AriM224/Beyblade-Melty-Brain-Kit/README.md

# Beyblade-Melty-Brain-Kit
First 1lb plastic melty brain combat robot kit! This repository will be mostly for the code.

*Please note that I'm a mechanical engineer, so the code may not meet CS standards*
