AriM224/Beyblade-Melty-Brain-Kit/Electronics/Brain Rot Parts List.xlsx

Item | Notes | Link | Quantity/bot | Price | Total Cost
Palm Beach 1100kv 2822 Weapon Motor | glue stator because bad pressfit | https://palmbeachbots.com/products/d2822-brushless-outrunner-1100kv-4mm-shaft-viper-compatible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 | 2 | $16.00 | $178.40
Repeat 35A AM32 ESC | Needs to be programmed | https://repeat-robotics.com/buy/am32/ | 2 | $25.00
GNB 3s 380mah Battery | lasts up to 5 minutes in testing | https://pyrodrone.com/products/gaoneng-gnb-380mah-3s-11-4v-hv-90c-lipo-battery-xt30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 | 1 | $12.00
Power Switch | Can turn off if not tightened enough | https://repeat-robotics.com/buy/fingertech-switch/ | 1 | $9.00
Ibus Reciever |  | https://www.amazon.com/Receiver-Output-AFHDS-2A-Turnigy-Controller/dp/B086W6LG8Z/ref=sr_1_1 | 1 | $16.00
ESP32 Board | Built in wifi antenna | https://www.adafruit.com/product/5426 | 1 | $12.50
Accelerometer |  | https://www.sparkfun.com/sparkfun-triple-axis-accelerometer-breakout-h3lis331dl.html | 1 | $17.00
Heading LED Strip |  | https://www.amazon.com/WS2812B-Individual-Addressable-144Pixels-Non-Waterproof/dp/B09PBGZMNS | 1 | $11.40
Custom PCB | Including various through hole components |  | 1 | $13.50
5v BEC | comes in 3 pack | https://www.amazon.com/Adjustable-Step-Down-Regulator-Quadcopter-Martian/dp/B07MS1ND5M/ref=sr_1_1 | 1 | $5.00
