AriM224/Beyblade-Melty-Brain-Kit/CAD/Main_Body.3mf

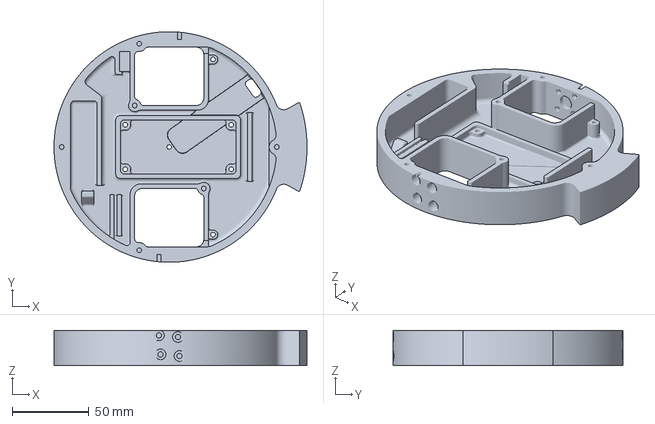
[picture p1: CAD file, 2025-11-16, last stored version]
CAD/Main_Body.3mf
164.6 x 150.0 x 23.0 mm
