AriM224/Beyblade-Melty-Brain-Kit/CAD/Wire_clamp.stl

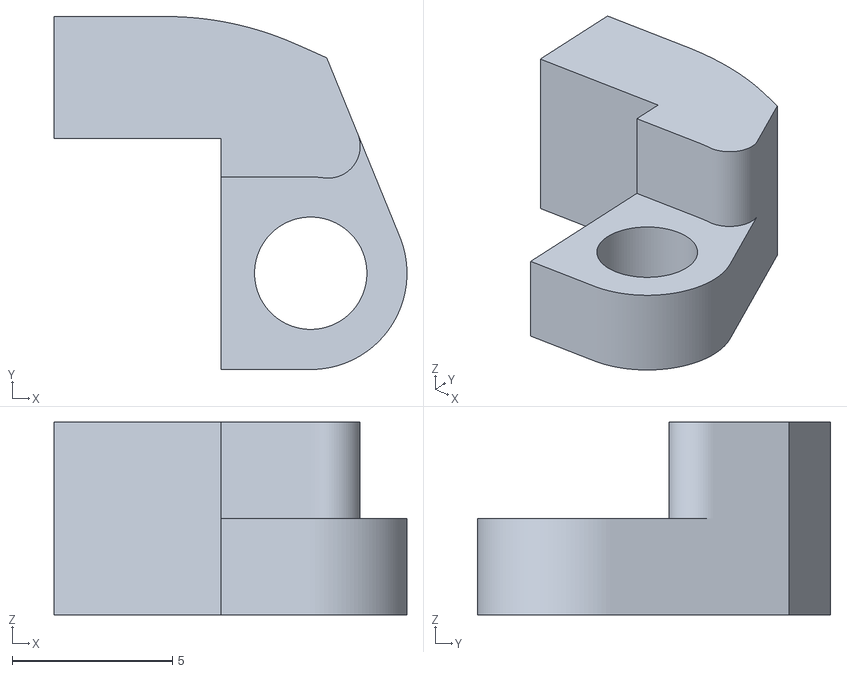
[picture p2: CAD file, 2025-11-21, last stored version]
CAD/Wire_clamp.stl
11.0 x 11.0 x 6.00
