AriM224/Beyblade-Melty-Brain-Kit/CAD/Top_Plate.stl

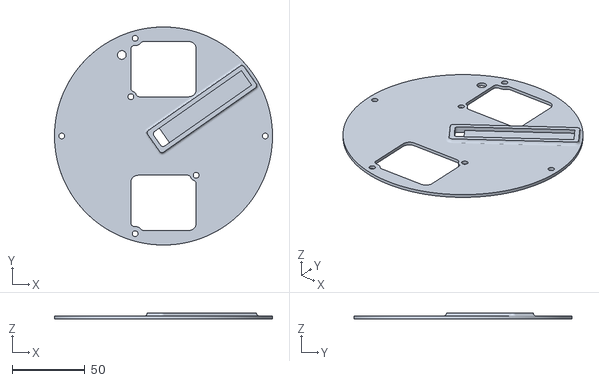
[picture p3: CAD file, 2025-11-16, last stored version]
CAD/Top_Plate.stl
150.0 x 150.0 x 4.00
