AriM224/Beyblade-Melty-Brain-Kit/CAD/Banebots_Wheel_Hub.stl

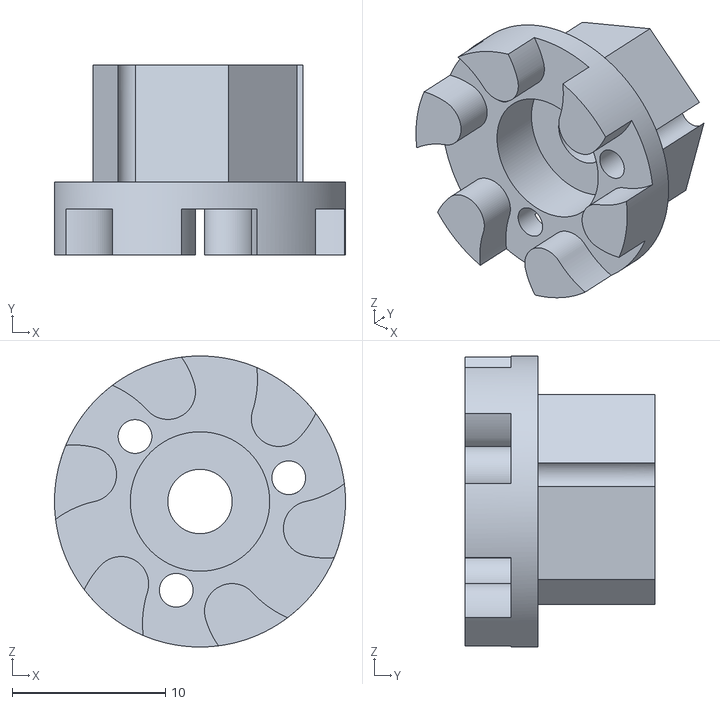
[picture p4: CAD file, 2025-11-16, last stored version]
CAD/Banebots_Wheel_Hub.stl
19.0 x 12.4 x 19.0
