AriM224/Beyblade-Melty-Brain-Kit/CAD/Wheel_Hubs.3mf

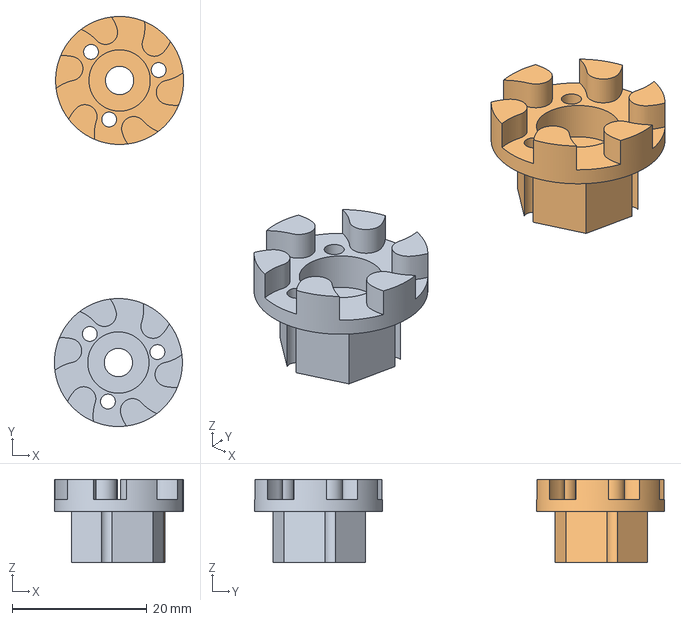
[picture p5: CAD file, 2025-11-16, last stored version]
CAD/Wheel_Hubs.3mf
19.2 x 60.9 x 12.4 mm
Banebots_Wheel_Hub.stl x 2
