AriM224/Beyblade-Melty-Brain-Kit/CAD/Wheel_Lock.stl

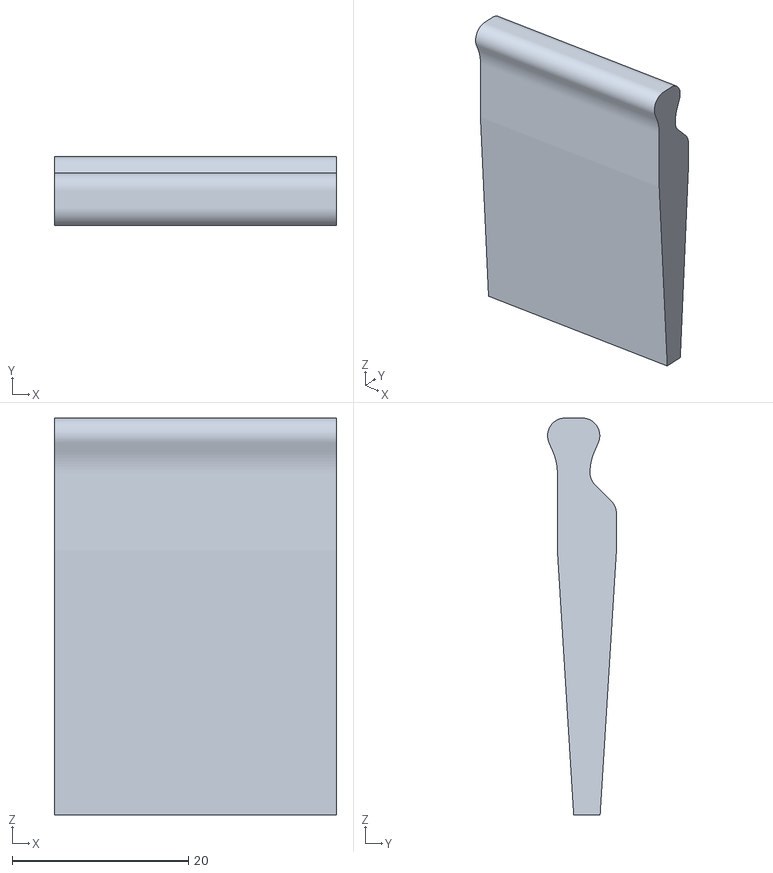
[picture p6: CAD file, 2025-11-07, last stored version]
CAD/Wheel_Lock.stl
32.0 x 7.81 x 45.0
