AriM224/Beyblade-Melty-Brain-Kit/(list of files, cad)

Other CAD files:
CAD/Main_Body.stl
