AriM224/Beyblade-Melty-Brain-Kit/Electronics/Schematic_Melty-Brain-PCB-V2_2025-09-14.pdf

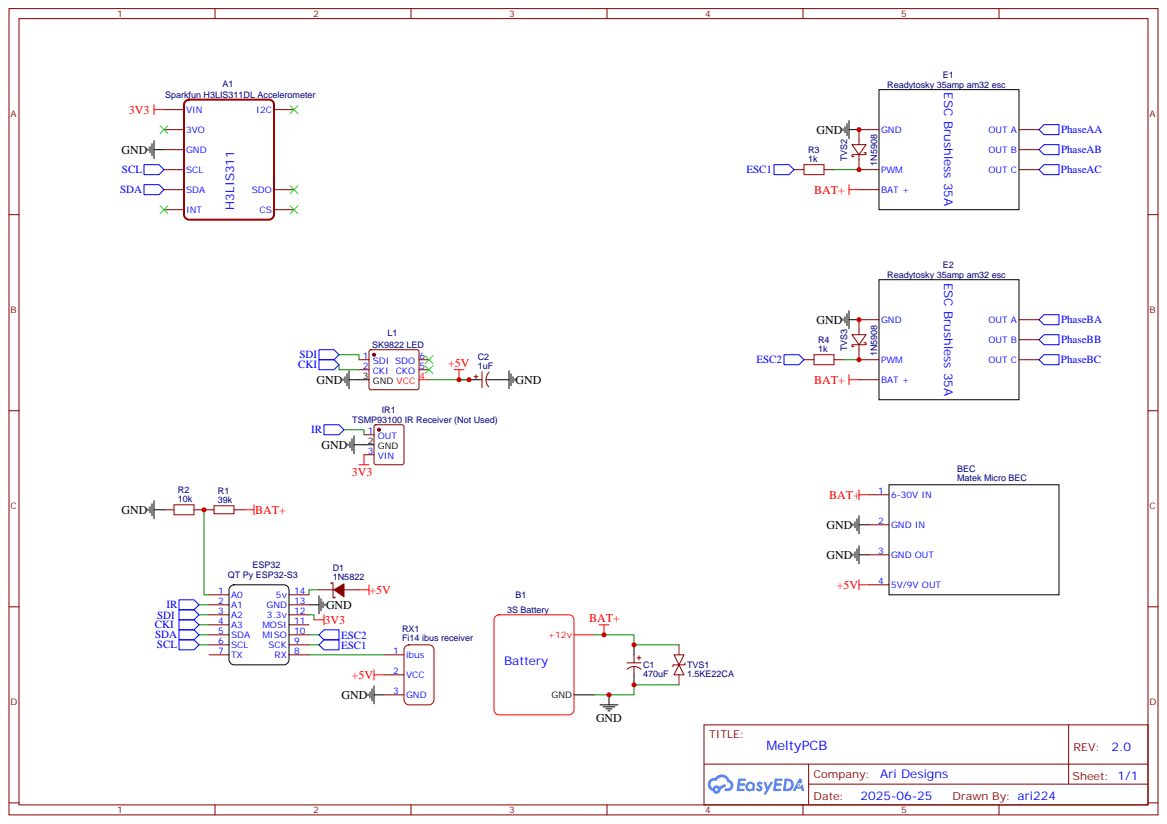
[picture p7: page 1]
