AriM224/Beyblade-Melty-Brain-Kit/Code/Main_V5.1/Main_V5.1.ino

#include <esp_task_wdt.h>
#include <Wire.h>
#include <SparkFun_LIS331.h>
#include <Adafruit_NeoPixel.h>
#include <SPI.h>
#include <IBusBM.h>
#include <WiFi.h>
#include <WiFiAP.h>
#include <ArduinoOTA.h>
#include <TelnetStream.h>
#include <Arduino.h>
#include "DShotESC.h"
#include <EEPROM.h>

//------accelerometer config------------
#define ACCEL_RANGE LIS331::HIGH_RANGE  //sets to 400g range
#define ACCEL_MAX_SCALE 400
#define ACCEL_I2C_ADDRESS 0x19 //0x18 for adafruit accel, 0x19 for sparkfun
LIS331 xl; //accelerometer object
const int accradius = 15; //radius where the g force sensor is located in millimeters

//-------ESC config--------
#define escR_gpio GPIO_NUM_36 //right esc pin assignment
#define escL_gpio GPIO_NUM_37  //left esc pin assignment
DShotESC escR;  // create servo object to control the left esc
DShotESC escL;  // create servo object to control the right esc
const bool reverse_1_motor = false;  //if both motors spin the same direction making the bot drive forward instead of spinning
//library uses values between -999 and 999 to control speed of esc

//---------Other pin assignemnts----------
const int volt_pin = A0; //pin for measure battery voltage

//------LED config--------
const int top_led_pin = A3;  //top led strip pin
const int bottom_led_pin = A2;  //bottom led strip pin
const int NUMPIXELST = 10; //number of leds in the top strip
const int NUMPIXELSB = 10; //number of leds in the bottom strip
const bool rvs_led_T = false;
const bool rvs_led_B = false;
#define RMT_CHANNEL_MAX 1 //limits rmt channels to use
Adafruit_NeoPixel top_strip(NUMPIXELST, top_led_pin, NEO_GRB + NEO_KHZ800);
Adafruit_NeoPixel bottom_strip(NUMPIXELSB, bottom_led_pin, NEO_GRB + NEO_KHZ800);
const int animSpeed = 100;   // ms between LED updates when in animation mode

//------Reciever config-----------
#define RXpin Serial1  //reciever pin assignment
IBusBM IBus;    // IBus object
const int NUM_CHANNELS = 6; //number of reciever channels to use

//------Driving characteristcs------
const int LEDheading = 315; //degree where the LED heading is centered, adjust for tuning heading vs driving direction
const int percentdecel = 15; //percentage of rotation the translation deceleration wave occurs for each motor. Should be <= 50
const float acc_rate = 0.4; //0.2(least aggressive spinup) - 1.0(most aggressive spinup)

//-------Wifi config---------
const char *ssid = "Beyblade"; //wifi ssid
const char *password = "meltybrain"; //wifi password
// Start TelnetStream: Enter telnet {insert ip address} for me: telnet 192.168.4.1 in CMD to view output

//-----other constants-------
const int denom = round((1.0 / sqrt(0.00001118*accradius))*3); //calculates denominator ahead of time to reduce unnecessary calculations;
const int OFFSET_ADDR = 0;  // EEPROM address to store rpm offset
const int WDT_TIMEOUT = 1;  // seconds

//=============GLOBAL VARIABLES==================
//-------LED control-------
String LEDStatus = "armed"; //tells LED control what mode to be in
unsigned long lastUpdate = 0;   // last LED animation update time
long stripstart = 0;   //time of last update
int animIndex = 0;     // position in LED animation
int direction = 1; // 1 = forward, -1 = backward
int ringRadius = 0;
int ringColorIndex = 0;
//-------rpm and heading calc--------
int rpm;
unsigned long long previoustime = 0; //will store last time that was updated
float heading = 1.0; //variable used to adjust heading using left transmitter stick
float offset = 1.0; //creates variable to tune a stable heading, will update from EEPROM in setup
int angle = 0; //creates a variable to track the rotation angle of the bot from its heading
int max_rpm = 0;  // stores the greatest rpm achieved
int max_gforce = 0; //for storing max gforce achieved
//--------translation----------
unsigned long long dtime; //variable for the time it's been since decel start
unsigned long long startime; //variable to store the time in microseconds that the decel started
bool startimeset = false;
bool off_set = false;
bool reversed = false;  //used for reverse spin direction
unsigned long long motorLsent = 0; //motor send timers
unsigned long long motorRsent = 1; //offsets it slightly from other motor
bool motorRsend = true;  //used to switch motor gets updated
unsigned long loopstart = 0; //stores last gforce read time
int motorL;
int motorR;
int spinspeed;
bool motorLsend = true;
//--------reciever----------
unsigned long chanstart = 0; //stores last RX read time
int pwm[NUM_CHANNELS]; //list values from 1000-2000
int duty[NUM_CHANNELS]; //list values from 0 - 100
int last_rec; //used to store update times for detecting signal loss
int rec_gap;
int rec_last;
bool rc_status = false; //whether getting rc signal, used for triggering failsafe
//----------other----------
float volts; //variable to store current battery voltage
int batloop; //variable for tracking battery update loop
long loop_time;
long loop_start;
bool motor_on = false;

//--------------------------------------------------------------------------------------------
void setup() 
{
  EEPROM.begin(512);  // Initialize EEPROM with 512 bytes of storage (adjust size if needed)
  offset = readOffsetFromEEPROM();
  Wire.begin();        //not sure what this does
  Wire.setClock(400000);  //makes reading the sensor faster somehow
  xl.setI2CAddr(ACCEL_I2C_ADDRESS); //has to do with the g force sensor
  xl.begin(LIS331::USE_I2C);  //starts I2C com with sensor
  xl.setFullScale(ACCEL_RANGE); //sets sensor scale
  IBus.begin(RXpin, IBUSBM_NOTIMER);    // iBUS object connected to RX pin and disables interrupt timer
  top_strip.begin(); //initializes LEDs
  bottom_strip.begin();
  top_strip.clear();  // Turn all LEDs off ASAP
  bottom_strip.clear();
  LEDStatus = "boot";
  updateLED();
  ArduinoOTA.setHostname("esp32-ap"); //wifi ota config
  ArduinoOTA.setPassword(nullptr); //no password required to upload code
  escR.install(escR_gpio, RMT_CHANNEL_3); //associates pins and RMT channels to esc objects
  escL.install(escL_gpio, RMT_CHANNEL_2);
  for (int i = 0; i < 2500; i++) //arm esc's
  {
    escR.writeData(0,true);
    delayMicroseconds(400);
    escL.writeData(0,true);
    delayMicroseconds(400);
  }
  escR.setReversed(false);
	escR.set3DMode(true);
  delayMicroseconds(200);
	escL.setReversed(false);
	escL.set3DMode(true);

  esp_task_wdt_init(WDT_TIMEOUT, true);  // Enable panic so ESP32 restarts, esp_task_wdt_reset(); feeds watchdog
  esp_task_wdt_add(NULL);  // Add current thread (loopTask) to WDT
  
}

//----------------------------------------------------------------------------------------
//functions

void get_battery()  //calculates battery voltage based on voltage divider input on pin A0
{
  if ((millis() - batloop) > 1000) //samples every second to avoid flickering
  {
    volts = (float(analogRead(volt_pin)) / float(310.0)) * 1.29;
    
    //caps voltage
    if(volts > 16.7)
    {
      volts = 16.7;
    }
    else if(volts < 13 && volts > 12.5)
    {
      volts = 12.5;
    }
    batloop = millis();
  }
}

void failsafe() //failsafe mode, shuts off all motors
{
      LEDStatus = "failsafe";
      motorR = 0;
      motorL = 0;
      updateLED();
}

//----------------------------------------------------------------------------------------
void loop() 
{
  get_battery();
  update_channels();
  heading_adj();
  heading_funct();
  calcrpm();
  if(duty[5] > 50)
  {
    wifi_mode();
  }
  if(duty[6] > 50 && duty[3] < 20) //only reverses spin direction if throttle is under 20%
  {
    reversed = true;
  }
  else if(duty[6] < 50 && duty[3] < 20)
  {
    reversed = false;
  }
    if(rpm > 400)
    {
     angle = rotation_angle();
     if((reversed == false && duty[6] > 50) || (reversed == true && duty[6] < 50)) //activates celebration led display if reverse switch is toggled while spinning
     {
      LEDStatus = "celebrate";
     }
     else if (isAngleInRange(LEDheading, 20)) // LED turns on within ±10° of heading
     {
        LEDStatus = "heading on";
     }
     else if(motor_on == true)
     {
       LEDStatus = "motor on";
     }
     else //turns off led
     {
       LEDStatus = "off";
     }
     if(duty[2] > 60 || duty[2] < 40)
     {
      translate();
     }
     else 
     {
      spin();
     }
    
    } //-------------------------------------------
    else if(duty[3] > 10)                              //spin command
    {
      spin();
    }
    else if(reversed == true && (duty[2] > 55 || duty[2] < 45)) //unstick using the right stick
    {
      motorL = map(duty[2], 0, 100, -1000, 1000);
      motorR = map(duty[2], 0, 100, 1000, -1000);
    }
    else if(duty[2] > 55 || duty[2] < 45 || duty[1] > 55 || duty[1] < 45) //tank drive mode
    {
      motorL = map(duty[2], 0, 100, -100, 100) + map(duty[1], 0, 100, -20, 20);
      motorR = map(duty[2], 0, 100, 100, -100) + map(duty[1], 0, 100, -20, 20);
    }
    else
    {
      motorL = 0;
      motorR = 0;
    }
    if(rpm < 400)
    {
      LEDStatus = "armed";
    }
  updateLED();
  loop_time = esp_timer_get_time() - loop_start;
  update_motors();
  loop_start = esp_timer_get_time();

}
