AriM224/Beyblade-Melty-Brain-Kit/(commit log)

2025-09-14 Added parts list, PCB schematic, and PCB gerber files
    [Brain Rot Parts List.xlsx]
2025-09-14 Added current code
    Still need to flush out the code for the new ESP32. Also will be adding more comments to it.
    [Brain Rot Parts List.xlsx]
2025-09-25 Working code with all libraries. Heading doesn't work yet, but it spins
    [Main_Body.3mf, Main_Body.stl, Top_Plate.stl]
2025-10-12 Did a lot of code cleanup.
    -LED animations
    -split functions to multiple files
    -deleted unnecessary global variables
    -organized variables and constants
    -still need to add more comments and update other comments throughout code
2025-11-07 bunch of code improvements. sine exp is the code to use now
    [Wheel_Lock.stl]
2025-11-16 banebots wheels
    [Banebots_Wheel_Hub.stl, Main_Body.3mf, Main_Body.stl, Top_Plate.stl, Wheel_Hubs.3mf]
2025-11-21 Deleted old code backups
    [Wire_clamp.stl]
2025-11-24 fixed rpm calculation which was off by a factor of 3
    [Heading.ino, LED_Control.ino, Motor_Control.ino]
2025-12-05 CAD is no longer going to be on here
    [Banebots_Wheel_Hub.stl, Main_Body.3mf, Main_Body.stl, Top_Plate.stl, Wheel_Hubs.3mf, Wheel_Lock.stl, Wire_clamp.stl]
2025-12-05 update parts lists
    [Brain Rot Parts List.xlsx]
2025-12-30 New Code Version
    Increased translation speed, new LED colors to distinguish between top and bottom. Improved ESC arming reliability.
2026-01-15 added reset issue testing file
    [Heading.ino, LED_Control.ino, Motor_Control.ino, RC_Handler.ino, V5_Testing.ino, Wifi_Handler.ino]
2026-01-28 Code updates to add functionality
    -new celebration mode
    -translation works forward or backward
    -ability to change LED strip direction
    -4s supported for status bar
2026-02-01 Removed boot delay and tested that esc's arm correctly without delay
    [Motor_Control.ino, Wifi_Handler.ino]
2026-02-04 Main_V5.1 has bugs from v5.1 testing fixed
    Battery voltage display won't show full when very low voltage, normal heading light, added celebration mode that may need tweaking still, deleted unnecessary data arrays and removed boot delay
    [Heading.ino, LED_Control.ino, Main_V5.1.ino, Motor_Control.ino, RC_Handler.ino, V5.1_Testing.ino]
